drgdlr09/Virtual-SandBox/bom.csv

Designator | Footprint | Quantity | Value | LCSC Part #
J1 | PinHeader_1x01_P2.54mm_Vertical | 1 | BAT+IN
J2 | PinHeader_1x01_P2.54mm_Vertical | 1 | BAT+OUT
J3 | PinHeader_1x04_P2.54mm_Vertical | 1 | 0.96\" OLED Screen
J4 | PinHeader_1x08_P2.54mm_Vertical | 1 | LIS3DH Accelerometer
SW1 | SW_PUSH_6mm | 1 | Button
SW2 | PinHeader_1x03_P2.54mm_Vertical | 1 | SW_SPDT
U3 | XIAO ESP32-S3 | 1 | XIAO-ESP32-S3
