drgdlr09/Virtual-SandBox/Design/Virtual SandBox copy.kicad_pcb

## KiCad design Design/Virtual SandBox copy.kicad_pcb (2026-11-01)

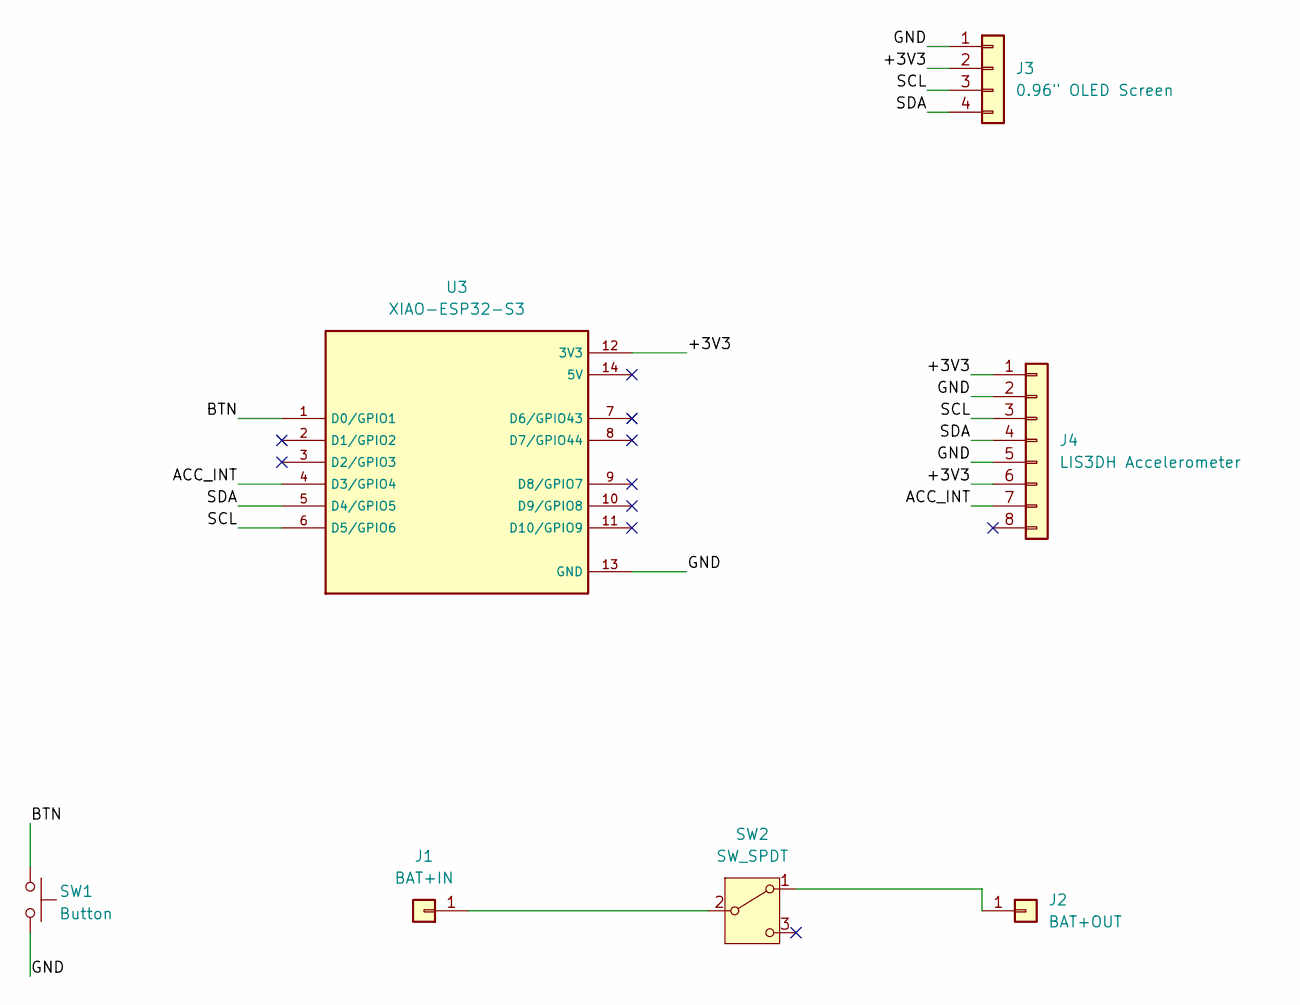
[picture p1: schematic Virtual SandBox copy.kicad_sch]

Parts:
J1: BAT+IN; PinHeader_1x01_P2.54mm_Vertical
J2: BAT+OUT; PinHeader_1x01_P2.54mm_Vertical
J3: 0.96" OLED Screen; PinHeader_1x04_P2.54mm_Vertical
J4: LIS3DH Accelerometer; PinHeader_1x08_P2.54mm_Vertical
SW1: Button; SW_PUSH_6mm
SW2: SW_SPDT; PinHeader_1x03_P2.54mm_Vertical
U3: XIAO-ESP32-S3; XIAO ESP32-S3; PARTREV April 22nd, 2026

Connections:
+3V3: J3.2, J4.1, J4.6, U3.12 (3V3)
ACC_INT: J4.7, U3.4 (D3/GPIO4)
BTN: SW1.1, U3.1 (D0/GPIO1)
GND: J3.1, J4.2, J4.5, SW1.2, U3.13 (GND)
N$SW2.1_J2.1: J2.1, SW2.1 (A)
N$SW2.2_J1.1: J1.1, SW2.2 (B)
SCL: J3.3, J4.3, U3.6 (D5/GPIO6)
SDA: J3.4, J4.4, U3.5 (D4/GPIO5)

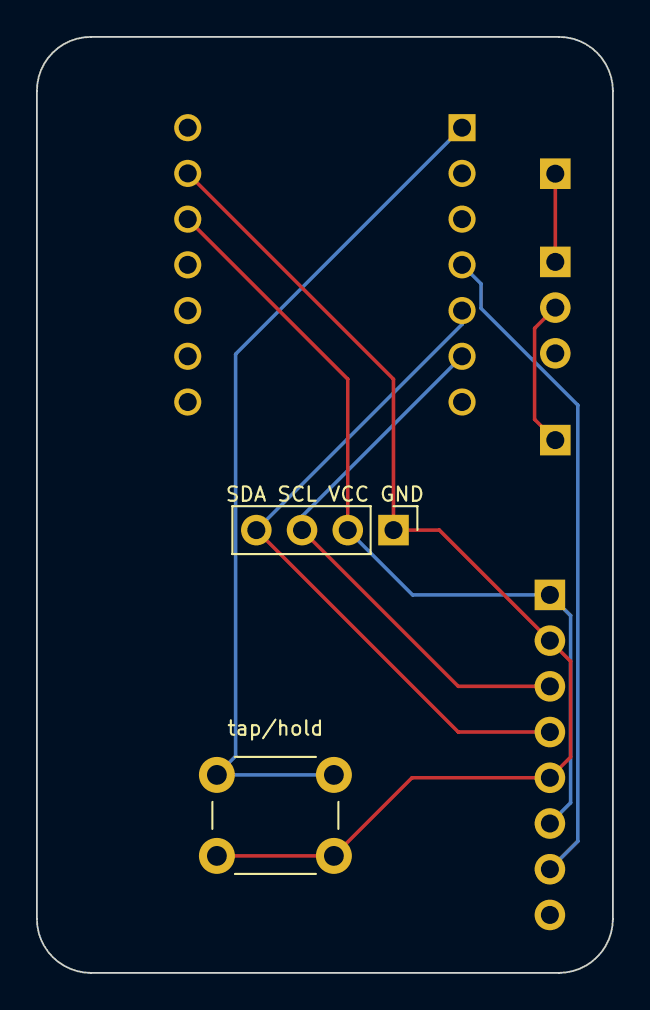
[picture p2: board Virtual SandBox copy.kicad_pcb from above]

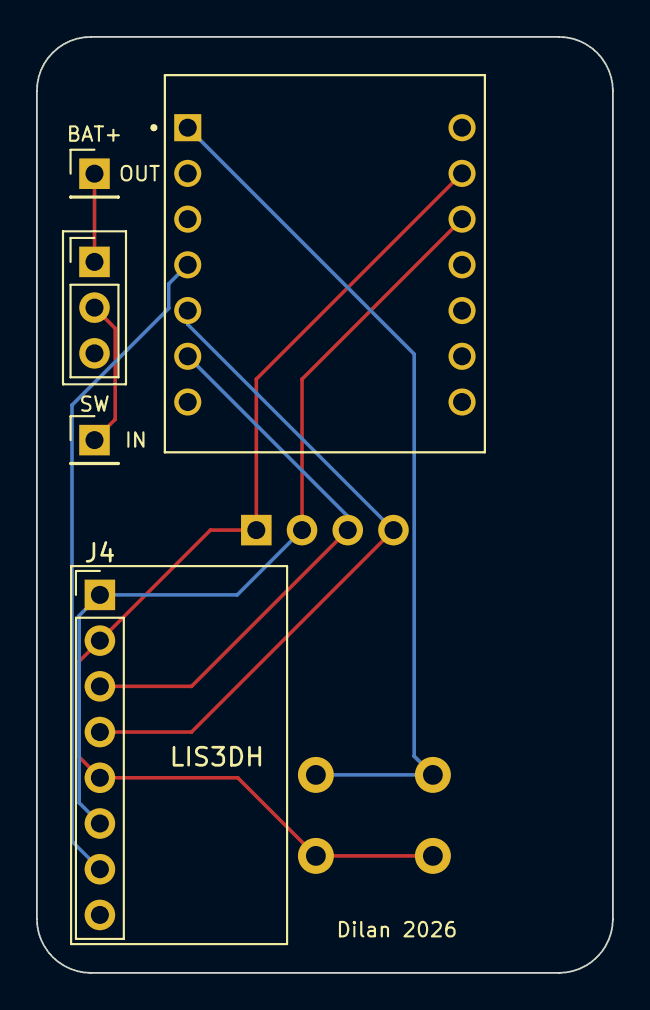
[picture p3: board Virtual SandBox copy.kicad_pcb from below]

Board: 2 copper layers, 32.0 x 52.0 mm, 7 parts (5 on the bottom side), 8 nets.
