drgdlr09/Virtual-SandBox/(commit log)

2026-10-26 Sync Virtual SandBox from Half Life
    [BOM.csv]
2026-11-01 Enhance README with images and component details
    Added images and additional details about the device's components and functionality.
